mariusmym/ESP8266-RJ45-Sensor-Board/SCHEMATIC/Schematic_RJ45-ESP_Sensor_module.png

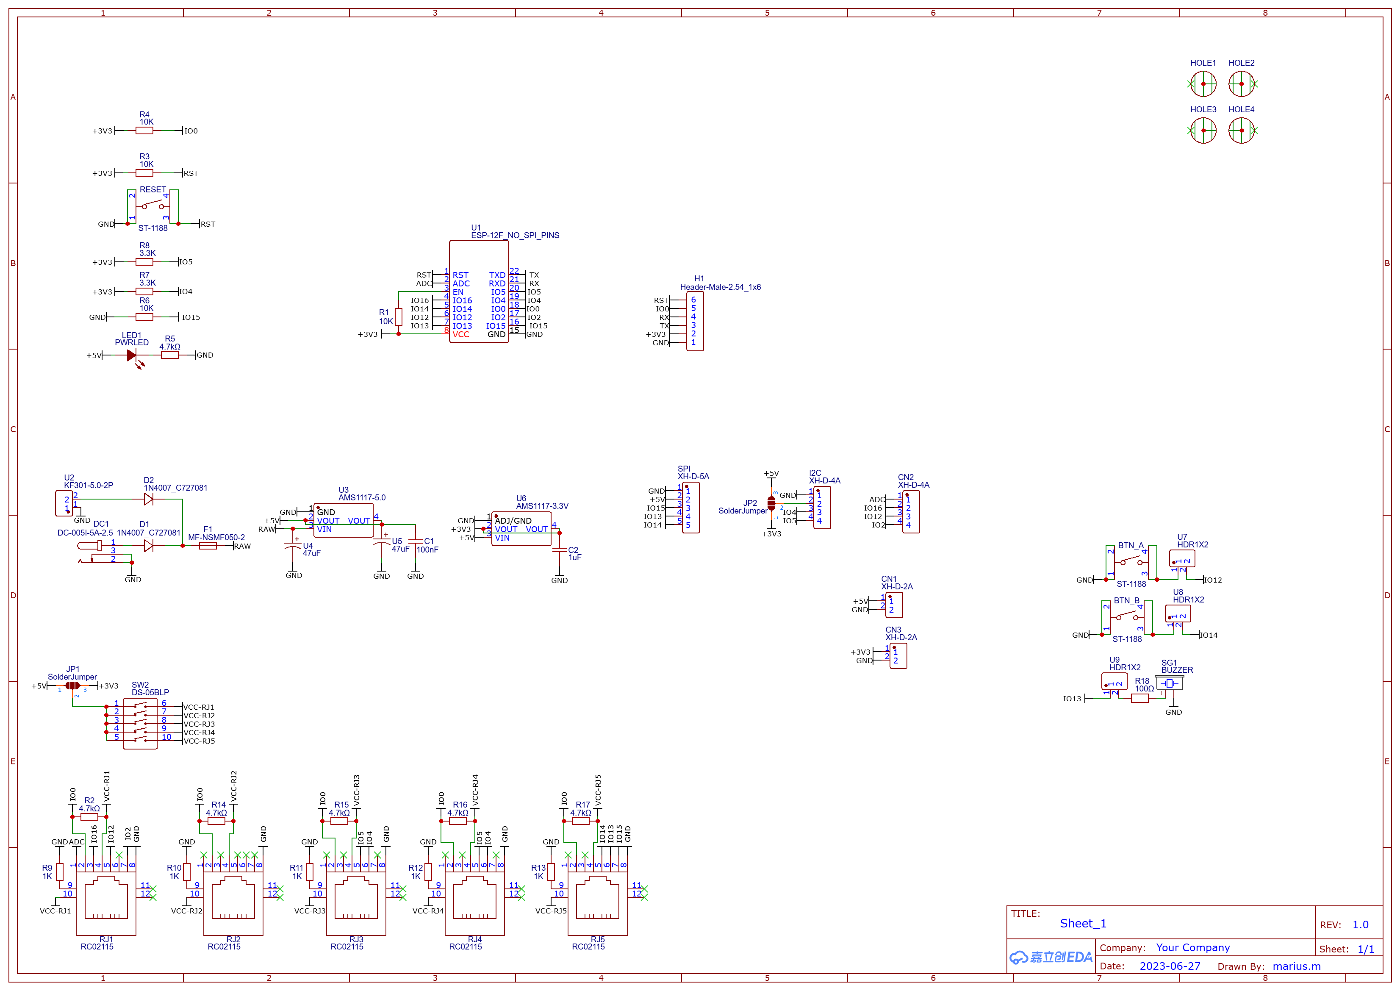
SCHEMATIC/Schematic_RJ45-ESP_Sensor_module.png
