mariusmym/ESP8266-RJ45-Sensor-Board/GERBER, BOM, PNP/BOM_RJ45-ESP_Sensor_module.csv

ID | Name | Designator | Footprint | Quantity | Manufacturer Part | Manufacturer | Supplier | Supplier Part
1 | 100Ω | R18 | R0805 | 1 | SR0805FR-07100RL | YAGEO(国巨) | LCSC | C723393
2 | MF-NSMF050-2 | F1 | F1206 | 1 | MF-NSMF050-2 | BOURNS | LCSC | C75464
3 | XH-D-2A | CN1,CN3 | CONN-TH_XH-2A | 2 | XH-D-2A | DEALON(德艺隆) | LCSC | C5160911
4 | XH-D-4A | CN2,I2C | CONN-TH_4P-P2.50_DEALON_XH-D-4A | 2 | XH-D-4A | DEALON(德艺隆) | LCSC | C5160913
5 | BUZZER | SG1 | DIP-BUZZER-12X9.5 | 1 |  |  | LCSC
6 | HDR1X2 | U9,U7,U8 | HDR-TH_2P-P2.54-V-M-1 | 3 | HDR1X2 | null | LCSC | C9900014921
7 | ST-1188 | BTN_A,BTN_B,RESET | SW-SMD_4P-L4.2-W3.2-P2.15-LS5.2 | 3 | ST-1188 | RI SHENG | LCSC | C589212
8 | 4.7kΩ | R5,R14,R15,R16,R17,R2 | R0805 | 6 | RMC08054.7K1%N | Tyohm(幸亚电阻) | LCSC | C269746
9 | XH-D-5A | SPI | CONN-TH_5P-P2.50_DEALON_XH-D-5A | 1 | XH-D-5A | DEALON(德艺隆) | LCSC | C5160914
10 | 100nF | C1 | C0805 | 1 | CC0805KRX7R7BB104 | YAGEO(国巨) | LCSC | C519980
11 | 1uF | C2 | C0805 | 1 | TCC0805X7R105K500DTS | CCTC(三环) | LCSC | C344178
12 | 1N4007_C727081 | D1,D2 | SMA_L4.3-W2.5-LS5.0-RD | 2 | 1N4007 | TWGMC(台湾迪嘉) | LCSC | C727081
13 | DC-005I-5A-2.5 | DC1 | DC-IN-TH_DC-005I-5A-2.5 | 1 | DC-005I-5A-2.5 | XKB Connectivity(中国星坤) | LCSC | C2689704
14 | Header-Male-2.54_1x6 | H1 | HDR-TH_6P-P2.54-V-M-1 | 1 | 2.54-1x6P直针 | BOOMELE(博穆精密) | LCSC | C37208
15 | PWRLED | LED1 | LED0603-RD | 1 | 19-21SURC/S530-A3/TR8 | EVERLIGHT | LCSC | C142275
16 | 10K | R1,R4,R6 | R0805 | 3 | PTFR0805D10K0P9 | ResistorToday | LCSC | C369943
17 | 10K | R3 | R0805 | 1 | RMS06JT103 | TA-I Tech | LCSC | C209220
18 | 3.3K | R7,R8 | R0805 | 2 | PTFR0805D10K0P9 | ResistorToday | LCSC | C369943
19 | RC02115 | RJ1,RJ2,RJ3,RJ4,RJ5 | RJ45-TH_RC02115 | 5 | RC02115 | RCH(瑞川) | LCSC | C708657
20 | DS-05BLP | SW2 | SW-TH_DS-05BLP | 1 | DS-05BLP | XKB Connectivity(中国星坤) | LCSC | C692503
21 | ESP-12F_NO_SPI_PINS | U1 | ESP12F_NO_SPI _PINS | 1 | ESP-12F | Ai-Thinker | LCSC | C89297
22 | KF301-5.0-2P | U2 | CONN-TH_P5.00_KF301-5.0-2P | 1 | KF301-5.0-2P | KEFA(科发) | LCSC | C474881
23 | AMS1117-5.0 | U3 | SOT-223_L6.5-W3.5-P2.30-LS7.0-BR | 1 | AMS1117-5.0 | AMS | LCSC | C6187
24 | 47uF | U4,U5 | CAP-TH_BD6.3-P2.5-D0.5 | 2 | 50V47uF CD288 | HRK(鸿瑞凯电子) | LCSC | C2960223
25 | AMS1117-3.3V | U6 | SOT-223-4_L6.5-W3.5-P2.30-LS7.0-BR | 1 | AMS1117-3.3V | WPMtek(维攀微) | LCSC | C2688239
26 | 1K | R9,R10,R11,R12,R13 | R0805 | 5 | PTFR0805D10K0P9 | ResistorToday | LCSC | C369943
