mariusmym/ESP8266-RJ45-Sensor-Board/SKETCH/RJ45_Board_A_B_ButtonsV4_2/graphic.h

#pragma once
#include <Arduino.h>
// 64x64 XBM check mark, stored in flash (PROGMEM) for u8g2.drawXBMP()
#define check_mark_width 64
#define check_mark_height 64
static const unsigned char check_mark_bits[] PROGMEM = {
   0x00, 0x00, 0x00, 0x00, 0x00, 0x00, 0x00, 0x00, 0x00, 0x00, 0x00, 0x00,
   0x00, 0x00, 0x00, 0x00, 0x00, 0x00, 0x00, 0x00, 0x00, 0x00, 0x00, 0x00,
   0x00, 0x00, 0x00, 0x00, 0x00, 0x00, 0x00, 0x00, 0x00, 0x00, 0x00, 0x00,
   0x00, 0x00, 0x00, 0x00, 0x00, 0x00, 0x00, 0x00, 0x00, 0x00, 0x00, 0x00,
   0x00, 0x00, 0x00, 0x00, 0x00, 0x00, 0xf0, 0x07, 0x00, 0x00, 0x00, 0x00,
   0x00, 0x00, 0xf8, 0x0f, 0x00, 0x00, 0x00, 0x00, 0x00, 0x00, 0xfe, 0x0f,
   0x00, 0x00, 0x00, 0x00, 0x00, 0x00, 0x8f, 0x07, 0x00, 0x00, 0x00, 0x00,
   0x00, 0xc0, 0xc7, 0x01, 0x00, 0x00, 0x00, 0x00, 0x00, 0xe0, 0xe1, 0x00,
   0x00, 0x00, 0x00, 0x00, 0x00, 0xf0, 0x70, 0x00, 0x00, 0x00, 0x00, 0x00,
   0x00, 0x78, 0x38, 0x00, 0x00, 0x00, 0x00, 0x00, 0x00, 0x1c, 0x3c, 0x00,
   0x00, 0x00, 0x00, 0x00, 0x00, 0x0e, 0x1e, 0x00, 0x00, 0x00, 0x00, 0x00,
   0x80, 0x07, 0x0f, 0x00, 0x00, 0x00, 0x00, 0x00, 0xc0, 0x03, 0x07, 0x00,
   0x00, 0x00, 0x00, 0x00, 0xe0, 0x81, 0x03, 0x00, 0x00, 0x00, 0x00, 0x00,
   0xf0, 0xc0, 0x01, 0x00, 0x00, 0x00, 0x00, 0x00, 0x78, 0xe0, 0x00, 0x00,
   0x00, 0x00, 0x00, 0x00, 0x3c, 0xf0, 0x00, 0x00, 0x00, 0x00, 0x00, 0x00,
   0x1e, 0x70, 0x00, 0x00, 0x00, 0x00, 0x00, 0x00, 0x0f, 0x38, 0x00, 0x00,
   0x00, 0x00, 0x00, 0x80, 0x07, 0x1c, 0x00, 0x00, 0x00, 0x00, 0x00, 0x80,
   0x03, 0x0e, 0x00, 0x00, 0x00, 0x00, 0x00, 0xc0, 0x01, 0x0e, 0x00, 0x00,
   0x00, 0x03, 0x00, 0xe0, 0x00, 0x07, 0x00, 0x00, 0x80, 0x0f, 0x00, 0x70,
   0x80, 0x03, 0x00, 0x00, 0xc0, 0x1f, 0x00, 0x38, 0xc0, 0x01, 0x00, 0x00,
   0xe0, 0x7c, 0x00, 0x1c, 0xc0, 0x01, 0x00, 0x00, 0x70, 0xf0, 0x00, 0x0e,
   0xe0, 0x00, 0x00, 0x00, 0x70, 0xe0, 0x03, 0x0f, 0x70, 0x00, 0x00, 0x00,
   0xe0, 0x80, 0x07, 0x07, 0x38, 0x00, 0x00, 0x00, 0xc0, 0x01, 0x9f, 0x03,
   0x38, 0x00, 0x00, 0x00, 0xc0, 0x01, 0xfc, 0x01, 0x1c, 0x00, 0x00, 0x00,
   0x80, 0x03, 0xf8, 0x00, 0x0e, 0x00, 0x00, 0x00, 0x00, 0x07, 0xf0, 0x00,
   0x0e, 0x00, 0x00, 0x00, 0x00, 0x0e, 0x00, 0x00, 0x07, 0x00, 0x00, 0x00,
   0x00, 0x0e, 0x00, 0x80, 0x03, 0x00, 0x00, 0x00, 0x00, 0x1c, 0x00, 0x80,
   0x03, 0x00, 0x00, 0x00, 0x00, 0x38, 0x00, 0xc0, 0x01, 0x00, 0x00, 0x00,
   0x00, 0x38, 0x00, 0xe0, 0x00, 0x00, 0x00, 0x00, 0x00, 0x70, 0x00, 0xe0,
   0x00, 0x00, 0x00, 0x00, 0x00, 0xe0, 0x00, 0x70, 0x00, 0x00, 0x00, 0x00,
   0x00, 0xe0, 0x00, 0x38, 0x00, 0x00, 0x00, 0x00, 0x00, 0xc0, 0x01, 0x38,
   0x00, 0x00, 0x00, 0x00, 0x00, 0x80, 0x03, 0x1c, 0x00, 0x00, 0x00, 0x00,
   0x00, 0x00, 0x07, 0x0c, 0x00, 0x00, 0x00, 0x00, 0x00, 0x00, 0x07, 0x0e,
   0x00, 0x00, 0x00, 0x00, 0x00, 0x00, 0x0e, 0x07, 0x00, 0x00, 0x00, 0x00,
   0x00, 0x00, 0x1c, 0x07, 0x00, 0x00, 0x00, 0x00, 0x00, 0x00, 0x9c, 0x03,
   0x00, 0x00, 0x00, 0x00, 0x00, 0x00, 0xb8, 0x01, 0x00, 0x00, 0x00, 0x00,
   0x00, 0x00, 0xf8, 0x01, 0x00, 0x00, 0x00, 0x00, 0x00, 0x00, 0xf0, 0x00,
   0x00, 0x00, 0x00, 0x00, 0x00, 0x00, 0xe0, 0x00, 0x00, 0x00, 0x00, 0x00,
   0x00, 0x00, 0x40, 0x00, 0x00, 0x00, 0x00, 0x00, 0x00, 0x00, 0x00, 0x00,
   0x00, 0x00, 0x00, 0x00, 0x00, 0x00, 0x00, 0x00, 0x00, 0x00, 0x00, 0x00,
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
